Atcold/altair-tn9k/digital/README.md

# digital

Circuits for [Digital](https://github.com/hneemann/Digital), Helmut Neemann's logic simulator: the 74HC595 and 74HC165 built from flip-flops and gates, each with its test cases embedded.

## Building the chips

1. Build each chip as its own circuit, `s2p-74HC595.dig` (serial to parallel) and `p2s-74HC165.dig` (parallel to serial), with In/Out components labelled exactly as in the test vectors:
   - 595: `SER SRCLK RCLK ~SRCLR ~OE` → `QA … QH QH'`
   - 165: `SH/~LD CLK CLK_INH SER A … H` → `QH ~QH`

   `~` marks an active-low pin, which Digital draws with a bar over the name.
2. Flip-flops: Digital's D flip-flop, with asynchronous inputs enabled for the 595's shift register and all 165 stages. Its `Set` and `Clr` are active high, so invert them with the component's inverted-input option to match the drawings in `diagrams/`.
3. Tri-state outputs of the 595: the Driver component, or its inverted-select variant driven by `~OE` directly.
4. Add a Test component to each circuit, paste in the matching block of test vectors, and run the tests.
5. Once both pass, give each circuit the DIL shape in its settings and use it as a chip in a third circuit: chain two of each and drive LEDs and DIP switches, as on the breadboard.

## Test vectors

```sh
./test_vectors.py   # writes 74hc595-74hc165-tests.txt and s2p-74HC595-animation.hex
```

They come from a behavioural model of each chip in `test_vectors.py`, not from the datasheets directly, so if a test fails, check the vector as well as the circuit.

## Animation

`s2p-74HC595-animation.dig` replays the 595 test: a 5-bit counter steps a ROM through one test row per tick, and a splitter fans each word out to the inputs. Bits 0 to 4 of each word, matching the splitter outputs top to bottom:

| bit | 0 | 1 | 2 | 3 | 4 |
|---|---|---|---|---|---|
| input | ~OE | RCLK | SER | ~SRCLR | SRCLK |

Addresses past the last row hold the idle word `8` (only ~SRCLR high). The ROM keeps its own copy of the data, so after changing the vectors rerun `./test_vectors.py` and reload the ROM from the `.hex`.
