Atcold/altair-tn9k/docs/165-by-hand.tex

% One 74HC165 driven by hand: eight switches loaded at once, clocked out one by one onto a single LED.
% Build with ./build.sh (figures, then latexmk; settings in .latexmkrc).

\documentclass[11pt,a4paper]{article}

\usepackage{fontspec}
\usepackage[margin=2.5cm]{geometry}
\usepackage{graphicx}
\usepackage{float}
\usepackage{enumitem}
\usepackage{chapter}
\usepackage[colorlinks=true,linkcolor=blue!50!black,urlcolor=blue!50!black]{hyperref}

\setlength{\parindent}{0pt}
\setlength{\parskip}{0.6em}

\title{One \name{74HC165} by hand}
\author{}
\date{}

\begin{document}
\maketitle

\section*{Parts}

\section*{Power}

\section*{Wiring}

\section*{Procedure}

\section*{Done when}

\revisiontable

\end{document}
