Atcold/altair-tn9k/docs/index.tex

% The list of write-ups, one entry per stage; each links to its chapter's PDF beside it in build/.
% Build with ./build.sh (settings in .latexmkrc), which also writes index.md from this file.

\documentclass[11pt,a4paper]{article}

\usepackage{fontspec}
\usepackage[margin=2.5cm]{geometry}
\usepackage{enumitem}
\usepackage{chapter}
\usepackage[colorlinks=true,linkcolor=blue!50!black,urlcolor=blue!50!black,filecolor=blue!50!black]{hyperref}

\setlist[description]{style=nextline, leftmargin=1.5em}  % here, not on the list: pandoc skips lists with options
\setlength{\parindent}{0pt}
\setlength{\parskip}{0.6em}

\title{Altair 8800 replica on a Tang Nano 9K\\[0.3em]\large Write-ups}
\author{}
\date{}

\begin{document}
\maketitle

One chapter per stage of the build: what to wire, why, and how to tell it works.

\section*{Stages}

\begin{description}
  \item[\href{running-leds.pdf}{Stage 0a: running LEDs, with Gowin EDA and the open-source flow}]
    The old LED project rebuilt in Gowin EDA, step by step; then the same two files through the open-source flow, from a \name{Makefile}.
  \item[\href{hello-analyser.pdf}{Stage 0b: hello world on the logic analyser}]
    A Verilog UART sends ‘Hello world’, read back by the logic analyser’s decoder and by a serial terminal.
  \item[\href{595-by-hand.pdf}{Stage 0c: one \name{74HC595} by hand}]
    Three buttons stand in for the FPGA: shift a byte in bit by bit, then latch it onto eight LEDs.
  \item[\href{595-by-fpga.pdf}{Stage 1a: a walking bit on the \name{74HC595}}]
    The FPGA takes the buttons’ place: one lit LED walks forward a bit at a time, then backward a byte at a time.
\end{description}

\section*{The board}

\begin{description}
  \item[\href{the-board.pdf}{What is on the board}]
    The board’s parts and the documents that describe them, the \name{BL702} microcontroller behind the USB-C port, and how a USB keyboard could reach the FPGA.
  \item[\href{factory.pdf}{The factory program}]
    What the board runs out of the box, why it can’t be copied, and the design that puts it back after a \texttt{make flash}.
\end{description}

\section*{Schematics}

\begin{itemize}
  \item \href{74hc595-74hc165-internals.pdf}{The \name{74HC595} and \name{74HC165} at flip-flop level}
  \item \href{altair-first-byte-schematic.pdf}{First byte: one byte in, one byte out}
  \item \href{altair-panel-sr-schematic.pdf}{Panel}
\end{itemize}

The parts list is \name{docs/parts.md} in the repo.

\revisiontable

\end{document}
