Atcold/altair-tn9k/docs/index.md

# Altair 8800 replica on a Tang Nano 9K: Write-ups

One chapter per stage of the build: what to wire, why, and how to tell it works.

## Stages

[Stage 0a: running LEDs, with Gowin EDA and the open-source flow](build/running-leds.pdf)  
The old LED project rebuilt in Gowin EDA, step by step; then the same two files through the open-source flow, from a Makefile.

[Stage 0b: hello world on the logic analyser](build/hello-analyser.pdf)  
A Verilog UART sends ‘Hello world’, read back by the logic analyser’s decoder and by a serial terminal.

[Stage 0c: one 74HC595 by hand](build/595-by-hand.pdf)  
Three buttons stand in for the FPGA: shift a byte in bit by bit, then latch it onto eight LEDs.

[Stage 1a: a walking bit on the 74HC595](build/595-by-fpga.pdf)  
The FPGA takes the buttons’ place: one lit LED walks forward a bit at a time, then backward a byte at a time.

## The board

[What is on the board](build/the-board.pdf)  
The board’s parts and the documents that describe them, the BL702 microcontroller behind the USB-C port, and how a USB keyboard could reach the FPGA.

[The factory program](build/factory.pdf)  
What the board runs out of the box, why it can’t be copied, and the design that puts it back after a `make flash`.

## Schematics

- [The 74HC595 and 74HC165 at flip-flop level](build/74hc595-74hc165-internals.pdf)

- [First byte: one byte in, one byte out](build/altair-first-byte-schematic.pdf)

- [Panel](build/altair-panel-sr-schematic.pdf)

The parts list is docs/parts.md in the repo.

*Generated from index.tex by build.sh, which also builds the PDFs into build/. Edit index.tex, not this file.*
