Atcold/altair-tn9k/kicad/74HC595-manual-test/74HC595-manual-test.kicad_sch

## KiCad design kicad/74HC595-manual-test/74HC595-manual-test.kicad_sch (2026-10-24)

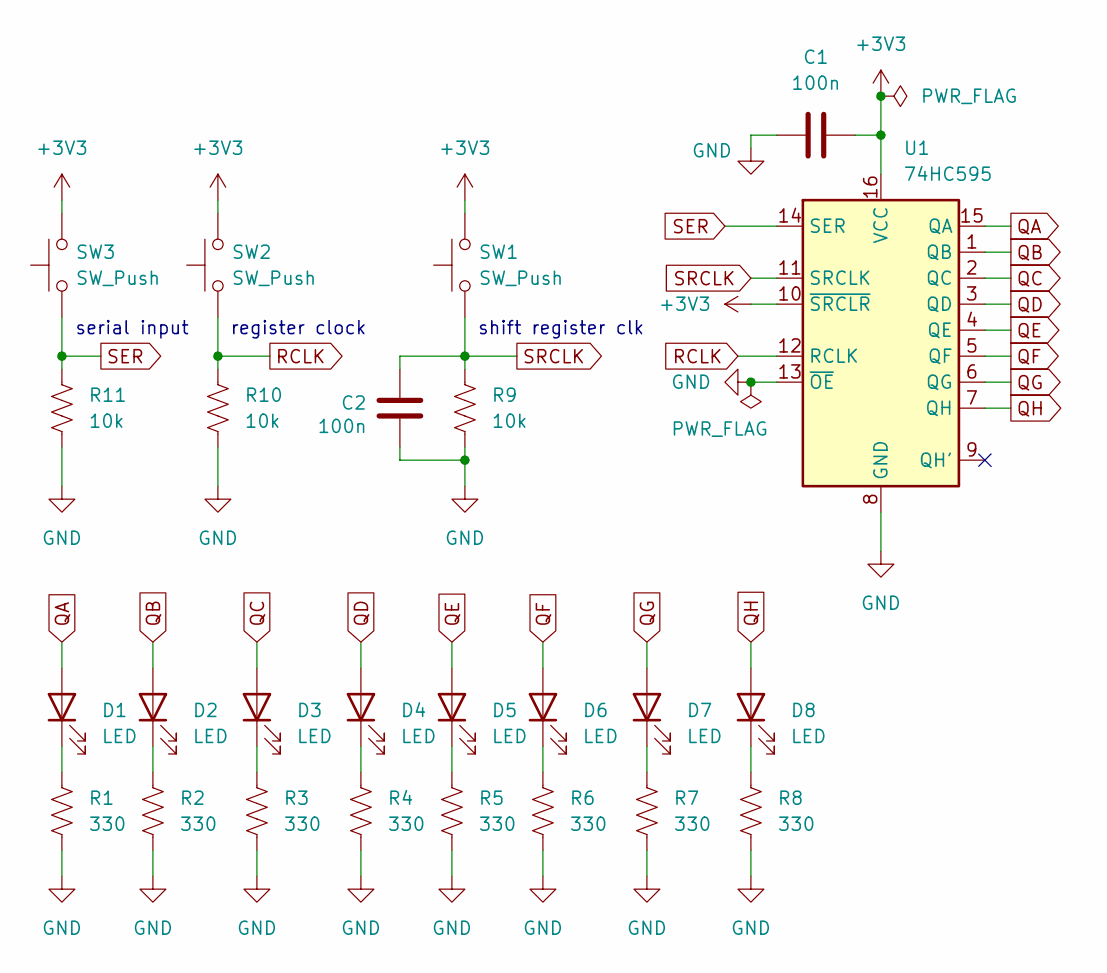
[picture p1: schematic 74HC595-manual-test.kicad_sch]

Parts:
C1, C2: 100n
D1, D2, D3, D4, D5, D6, D7, D8: LED
R1, R2, R3, R4, R5, R6, R7, R8: 330
R9, R10, R11: 10k
SW1, SW2, SW3: SW_Push
U1: 74HC595

Connections:
+3V3: C1.2, SW1.2, SW2.2, SW3.2, U1.10 (~SRCLR), U1.16 (VCC)
GND: C1.1, C2.2, R1.2, R2.2, R3.2, R4.2, R5.2, R6.2, R7.2, R8.2, R9.2, R10.2, R11.2, U1.8 (GND), U1.13 (~OE)
unnamed: D1.1 (K), R1.1
unnamed: D2.1 (K), R2.1
unnamed: D3.1 (K), R3.1
unnamed: D4.1 (K), R4.1
unnamed: D5.1 (K), R5.1
unnamed: D6.1 (K), R6.1
unnamed: D7.1 (K), R7.1
unnamed: D8.1 (K), R8.1
QA: D1.2 (A), U1.15 (QA)
QB: D2.2 (A), U1.1 (QB)
QC: D3.2 (A), U1.2 (QC)
QD: D4.2 (A), U1.3 (QD)
QE: D5.2 (A), U1.4 (QE)
QF: D6.2 (A), U1.5 (QF)
QG: D7.2 (A), U1.6 (QG)
QH: D8.2 (A), U1.7 (QH)
RCLK: R10.1, SW2.1, U1.12 (RCLK)
SER: R11.1, SW3.1, U1.14 (SER)
SRCLK: C2.1, R9.1, SW1.1, U1.11 (SRCLK)

Notes on the sheet:
shift register clk
serial input
register clock
