Atcold/altair-tn9k/diagrams/chips.py

"""74HC595 and 74HC165 drawn at flip-flop level, plus their function tables and pinouts.

Each sheet_* function returns one A3 figure; SHEETS lists them in PDF order.
"""
import schemdraw
import schemdraw.elements as elm
import schemdraw.logic as logic

from schematic import FS, T, page, canvas, finish, notes, table, tag, tunnel, ff, OV, net_colour

N = 3            # sheets in this set
TK = (0.36, 1.2, 1.1)   # tag sizing for these larger drawings: width per character, end padding, height
TKO = (0.36, 2.0, 1.1)  # output tags: extra room around the text
TK5 = (0.27, 1.0, 0.85) # the 74HC165 sheet is drawn larger, so its tags need less


def bus(d, y, xa, xb, text, k=None, kind="pin"):
    d.add(elm.Line().at((xa, y)).to((xb, y)).color(net_colour(text)))
    d.add(elm.Line().at((xa, y)).left(0.01)); tag(d, text, "left", k or TK, kind)


def clock_drops(d, flops, y):
    """Clock bus taps: from each flip-flop's clock input down to the bus at height y."""
    for c, f in enumerate(flops):
        cx = f.C.x - 0.5
        d.add(elm.Line().at(f.C).to((cx, f.C.y)).color(T.CLOCK))
        d.add(elm.Line().at((cx, f.C.y)).to((cx, y)).color(T.CLOCK))
        if c < len(flops) - 1:
            d.add(elm.Dot().at((cx, y)).color(T.CLOCK))


# ================================================================ 74HC595
def sheet_595():
    fig, fr = page(1, N, "74HC595 at flip-flop level: 8-bit shift register + 8-bit storage register + tri-state outputs",
                   "74HC595 internals")
    ax = canvas(fig, [0.03, 0.27, 0.94, 0.65])
    d = schemdraw.Drawing(canvas=ax, show=False)
    PITCH, SOFF, SY, ROW = 12.0, 6.2, -7.2, 22.0
    names = "ABCDEFGH"
    outs = ["QA (15)", "QB (1)", "QC (2)", "QD (3)", "QE (4)", "QF (5)", "QG (6)", "QH (7)"]
    DT, CT = T.DATA, T.CONTROL
    for r in range(2):
        Y = -r * ROW
        sh, st, tris = [], [], []
        for c in range(4):
            i = 4 * r + c
            x = c * PITCH
            sh.append(d.add(ff([(OV("CLR"), "CLR")], w=3.0, h=3.6, label=f"shift {names[i]}").at((x, Y))))
            st.append(d.add(ff(w=3.0, h=3.6, label=f"store {names[i]}").at((x + SOFF, Y + SY))))
        x0 = sh[0].D.x - 2.2
        d.add(elm.Line().at(sh[0].D).left(2.2).color(DT))
        if r == 0:
            tag(d, "SER  (14)", "left", TK)
        else:
            tunnel(d, "shift D→E", "left")
        for c in range(4):
            i = 4 * r + c
            q = sh[c].Q
            tapx = q.x + 0.6
            if c < 3:
                d.add(elm.Line().at(q).to(sh[c + 1].D).color(DT))
            else:
                d.add(elm.Line().at(q).right(2.5).color(DT))
                if i == 7:
                    tag(d, "QH'  (9)", "right", TK)
                else:
                    tunnel(d, "shift D→E", "right")
            d.add(elm.Dot().at((tapx, q.y)).color(DT))
            d.add(elm.Line().at((tapx, q.y)).to((tapx, st[c].D.y)).color(DT))
            d.add(elm.Line().at((tapx, st[c].D.y)).to(st[c].D).color(DT))
        yclr = sh[0].CLR.y + 0.9
        bus(d, yclr, x0, sh[3].CLR.x, OV("SRCLR") + "  (10)")
        for c, s_ in enumerate(sh):
            d.add(elm.Line().at(s_.CLR).to((s_.CLR.x, yclr)).color(CT))
            if c < 3:
                d.add(elm.Dot().at((s_.CLR.x, yclr)).color(CT))
        ysck = sh[0].C.y - 2.6  # low enough to clear the "shift A" names under the boxes
        bus(d, ysck, x0, sh[3].C.x - 0.5, "SRCLK  (11)")
        yrck = st[0].C.y - 2.6
        bus(d, yrck, x0, st[3].C.x - 0.5, "RCLK  (12)")
        clock_drops(d, sh, ysck)
        clock_drops(d, st, yrck)
        ytri = yrck - 1.4  # output buffers sit below the RCLK bus, drawn left to right
        for c, t in enumerate(st):
            i = 4 * r + c
            xb = t.Q.x + 0.8
            d.add(elm.Line().at(t.Q).to((xb, t.Q.y)).color(DT))
            d.add(elm.Line().at((xb, t.Q.y)).to((xb, ytri)).color(DT))
            # non-inverting tri-state buffer (schemdraw's default is an inverter); flip: enable underneath
            tb = d.add(logic.Tristate(outputnot=False).right().flip().at((xb, ytri)).length(2.4))
            tris.append(tb)
            d.add(elm.Line().at(tb.end).right(0.3).color(DT))
            tag(d, outs[i], "right", TKO)
        yoe = ytri - 1.6  # OE bus below the buffers
        for c, tb in enumerate(tris):
            d.add(elm.Line().at(tb.c).to((tb.c.x, yoe)).color(CT))
            if c < 3:
                d.add(elm.Dot().at((tb.c.x, yoe)).color(CT))
        if r == 0:
            d.add(elm.Line().at((x0 + 4.2, yoe)).to((tris[3].c.x, yoe)).color(CT))
            d.add(logic.Not().right().at((x0 + 0.6, yoe)).length(3.6).color(CT))
            d.add(elm.Line().at((x0 + 0.6, yoe)).left(0.01)); tag(d, OV("OE") + "  (13)", "left", TK)
            d.add(elm.Label().at((x0 + 5.2, yoe + 0.6)).label("OE (internal)", fontsize=FS - 1))
        else:
            bus(d, yoe, x0, tris[3].c.x, "OE (internal)", kind="tunnel")
    finish(d, ax, pad=0.5)

    notes(fr, 0.03, 0.245, [
        "Shift register: on each rising edge of SRCLK, SER enters stage A and every stage passes its bit to the next (A→B→…→H).",
        "Stage H also drives QH' (pin 9), the serial output used to chain the next 595. QH' is never tri-stated.",
        "Storage register: on each rising edge of RCLK, all eight shift-register bits are copied at once into the storage flip-flops,",
        "which is why the LEDs never show bits sliding past: outputs only change on RCLK.",
        f"{OV('SRCLR')} low clears the shift register only (asynchronously). The storage register keeps its value until the next RCLK.",
        f"{OV('OE')} high puts QA–QH in high impedance. On the panel it is tied to GND, so outputs are always driven.",
        "Drawn in two rows for legibility. Pointed boxes are pins; a filled triangle is a tunnel, the same wire as the one with its name.",
        "All flip-flops are rising-edge D-types (the wedge marks the clock input).",
    ], title="How it works", size=10)
    return fig


# ================================================================ 74HC165
def sheet_165():
    fig, fr = page(2, N, "74HC165 at flip-flop level: 8-bit shift register with asynchronous parallel load",
                   "74HC165 internals")
    ax = canvas(fig, [0.03, 0.27, 0.94, 0.65])
    d = schemdraw.Drawing(canvas=ax, show=False)
    PITCH, ROW = 9.5, 15.8
    names = "ABCDEFGH"
    pins_in = ["A (11)", "B (12)", "C (13)", "D (14)", "E (3)", "F (4)", "G (5)", "H (6)"]
    DT, CT = T.DATA, T.CONTROL
    for r in range(2):
        Y = -r * ROW
        fs_ = []
        for c in range(4):
            i = 4 * r + c
            fs_.append(d.add(ff([(OV("PRE"), "PRE"), (OV("CLR"), "CLR")], w=5.0, h=3.6, label=f"stage {names[i]}",
                                qn=(i == 7)).at((c * PITCH, Y))))  # only stage H's Q-bar is used: pin 7
        x0 = fs_[0].D.x - 2.2
        d.add(elm.Line().at(fs_[0].D).left(2.2).color(DT))
        if r == 0:
            tag(d, "SER  (10)", "left", TK5)
        else:
            tunnel(d, "stage D→E", "left")
        for c in range(3):
            d.add(elm.Line().at(fs_[c].Q).to(fs_[c + 1].D).color(DT))
        if r == 0:
            d.add(elm.Line().at(fs_[3].Q).right(1.8).color(DT)); tunnel(d, "stage D→E", "right")
        else:
            d.add(elm.Line().at(fs_[3].Q).right(1.8).color(DT)); tag(d, "QH  (9)", "right", TK5)
            d.add(elm.Line().at(fs_[3].QN).right(1.8).color(DT)); tag(d, OV("QH") + "  (7)", "right", TK5)

        gl = 1.85
        yload = fs_[0].PRE.y + 0.5 + gl + 1.4
        for c, f in enumerate(fs_):
            i = 4 * r + c
            pre, clr = f.PRE, f.CLR
            # input 1 of each NAND is SH/LD, active low (bubble)
            n1 = d.add(logic.Nand(inputnots=[1]).down().anchor("out").at((pre.x, pre.y + 0.5)))
            d.add(elm.Line().at(n1.out).to(pre).color(CT))
            n2 = d.add(logic.Nand(inputnots=[1]).down().anchor("out").at((clr.x, clr.y + 0.5)))
            d.add(elm.Line().at(n2.out).to(clr).color(CT))
            ydot = pre.y + 0.25
            xm = (pre.x + clr.x) / 2
            ytop = n2.in2.y + 0.5
            d.add(elm.Dot().at((pre.x, ydot)).color(CT))
            d.add(elm.Line().at((pre.x, ydot)).to((xm, ydot)).color(CT))
            d.add(elm.Line().at((xm, ydot)).to((xm, ytop)).color(CT))
            d.add(elm.Line().at((xm, ytop)).to((n2.in2.x, ytop)).color(CT))
            d.add(elm.Line().at((n2.in2.x, ytop)).to(n2.in2).color(CT))
            for g in (n1, n2):
                d.add(elm.Line().at(g.in1).to((g.in1.x, yload)).color(CT))
                if not (c == 3 and g is n2):
                    d.add(elm.Dot().at((g.in1.x, yload)).color(CT))
            # parallel input: up from the left NAND, then left into an input tag
            top = (n1.in2.x, yload + 1.5)
            d.add(elm.Line().at(n1.in2).to(top).color(DT))
            d.add(elm.Line().at(top).left(0.8).color(DT))
            tag(d, pins_in[i], "left", TK5)
        bus(d, yload, x0, fs_[3].CLR.x + 0.25, "SH/" + OV("LD") + "  (1)", TK5)

        yck = fs_[0].C.y - 2.6  # low enough to clear the "stage A" names under the boxes
        clock_drops(d, fs_, yck)
        if r == 0:
            # OR gate far enough left that the CLK (internal) name fits before the first branch
            K = T.CLOCK
            org = d.add(logic.Or().right().anchor("out").at((x0 - 1.4, yck)))
            d.add(elm.Line().at(org.out).to((fs_[3].C.x - 0.5, yck)).color(K))
            d.add(elm.Label().at((x0 - 0.5, yck + 0.45)).label("CLK (internal)", fontsize=FS - 1))
            d.add(elm.Line().at(org.in1).left(0.6).color(K)); d.add(elm.Line().up(0.6).color(K))
            d.add(elm.Line().left(0.4).color(K))
            tag(d, "CLK  (2)", "left", TK5)
            d.add(elm.Line().at(org.in2).left(0.6).color(K)); d.add(elm.Line().down(0.6).color(K))
            d.add(elm.Line().left(0.4).color(K))
            tag(d, "CLK INH  (15)", "left", TK5)
        else:
            bus(d, yck, x0, fs_[3].C.x - 0.5, "CLK (internal)", TK5, kind="tunnel")
    finish(d, ax, pad=0.5)

    notes(fr, 0.03, 0.245, [
        f"Parallel load: SH/{OV('LD')} goes to every stage. While it is low, the two NANDs (bubble = active-low input) turn the input bit into an asynchronous preset or clear:",
        f"input 1  →  left NAND outputs 0  →  {OV('PRE')} active  →  Q = 1;   input 0  →  right NAND outputs 0  →  {OV('CLR')} active  →  Q = 0.",
        "The load is asynchronous and continuous: while SH/LD is low, Q follows the inputs and the clock is ignored.",
        "Shift: with SH/LD high both NANDs output 1 (inactive). Each rising edge of the internal clock moves SER into A and A…G into B…H.",
        "QH is stage H, so right after a load it already shows input H: the first bit is readable before any clock pulse.",
        "Internal clock = CLK OR CLK INH, so either input held high blocks the other. Change CLK INH only while CLK is high, or its edge acts as a clock.",
        "Drawn in two rows for legibility. Pointed boxes are pins; a filled triangle is a tunnel, the same wire as the one with its name.",
        "All flip-flops are rising-edge D-types (the wedge marks the clock input).",
    ], title="How it works", size=10)
    return fig


# ================================================================ tables
def sheet_tables():
    fig, fr = page(3, N, "Function tables and pinouts", "Function tables, pinouts")
    table(fig, [0.03, 0.62, 0.45, 0.28], "74HC595 function table  (↑ = rising edge)",
          ["SER", "SRCLK", OV("SRCLR"), "RCLK", OV("OE"), "Effect"],
          [["X", "X", "X", "X", "H", "QA–QH high impedance (QH' unaffected)"],
           ["X", "X", "L", "X", "X", "Shift register cleared"],
           ["L", "↑", "H", "X", "X", "Shift; stage A = 0"],
           ["H", "↑", "H", "X", "X", "Shift; stage A = 1"],
           ["X", "X", "X", "↑", "X", "Shift register copied to storage"],
           ["X", "X", "X", "X", "L", "Storage driven onto QA–QH"]],
          [0.07, 0.10, 0.10, 0.09, 0.08, 0.56])
    table(fig, [0.52, 0.62, 0.45, 0.28], "74HC165 function table",
          ["SH/" + OV("LD"), "CLK", "CLK INH", "Effect"],
          [["L", "X", "X", "Parallel load: A–H copied to stages (async)"],
           ["H", "L", "L", "Hold"],
           ["H", "↑", "L", "Shift; SER → A, …, G → H"],
           ["H", "X", "H", "Hold (clock inhibited)"],
           ["H", "L", "↑", "Shift (the two clock inputs are interchangeable)"],
           ["H", "H", "X", "Hold"]],
          [0.11, 0.09, 0.12, 0.68])

    table(fig, [0.03, 0.33, 0.45, 0.24], "DIP-16 pinouts (top view, pin 1 top left)",
          ["Pin", "74HC595", "Pin", "74HC595", "Pin", "74HC165", "Pin", "74HC165"],
          [["1", "QB", "16", "VCC", "1", "SH/" + OV("LD"), "16", "VCC"],
           ["2", "QC", "15", "QA", "2", "CLK", "15", "CLK INH"],
           ["3", "QD", "14", "SER", "3", "E", "14", "D"],
           ["4", "QE", "13", OV("OE"), "4", "F", "13", "C"],
           ["5", "QF", "12", "RCLK", "5", "G", "12", "B"],
           ["6", "QG", "11", "SRCLK", "6", "H", "11", "A"],
           ["7", "QH", "10", OV("SRCLR"), "7", OV("QH"), "10", "SER"],
           ["8", "GND", "9", "QH'", "8", "GND", "9", "QH"]],
          [0.08, 0.17, 0.08, 0.17, 0.08, 0.17, 0.08, 0.17], fs=8.5)

    notes(fr, 0.03, 0.28, [
        "Pin names with a bar are active low.",
        "Sources: TI SN74HC595 and SN74HC165 datasheets (logic diagrams and function tables).",
    ], size=9)
    return fig


SHEETS = [sheet_595, sheet_165, sheet_tables]
