Atcold/altair-tn9k/(commit log)

2026-10-06 Initial layout: two panel backends, KiCad, Digital, notebooks
2026-10-06 Add schematic notebook and Digital test vectors
    diagrams/: schemdraw drawings of the shift-register panel (five sheets)
    and of the 74HC595 and 74HC165 at flip-flop level (three sheets), shown
    one per cell in schematics.ipynb; build_pdfs.py writes them as PDFs to
    docs/, light by default or --dark.
    digital/: test-vector generator for the two chips and notes on building
    them in Digital.
    pyproject.toml and uv.lock define the Python environment.
    [build_pdfs.py, chips.py, panel_sr.py, schematic.py]
2026-10-06 Add SPI-expander panel sheets; tidy symbols on both backends
    panel_mcp.py draws the MCP23S17 backend in five sheets: block diagram,
    carrier and connector, output expander, input expander, and bit maps
    with the start-up register writes. The notebook shows them and
    build_pdfs.py writes them as a third PDF; the panel PDFs are now named
    by backend.
    On both backends: toggle glyphs under the input chips in the block
    diagrams, LED part references LED1..LED36 instead of D1..D36 (which
    clashed with the data lights D0..D7), accurate "alike" sheet titles,
    a node where the decoupling capacitor meets the supply, and X marks on
    unconnected pins.
2026-10-06 First-byte breadboard sheet, colour themes, reworked chip internals
    diagrams/first_byte.py: the first breadboard, one byte each way on both
    backends sharing one DIP switch, plus a sheet of FPGA pins, parts and
    test. The panel sets drop their breadboard-subset tables.
    Themes: light (colour, the PDF default), dark (notebook) and mono
    (black and white); build_pdfs.py takes --dark or --mono. Nets are
    coloured by kind: supply, ground, clocks, each backend's signals, the
    shared switch lines, chip-internal data and control, LEDs.
    Net tags are drawn as text boxes sized in points, so they are the same
    size on every sheet.
    Chip internals: clock wedges on the flip-flops, non-inverting output
    buffers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
    [build_pdfs.py, chips.py, first_byte.py, panel_mcp.py, panel_sr.py, schematic.py]
2026-10-07 Add 74HC595 shift stage in Digital; use ~ for active-low pins
2026-10-08 Complete 74HC595 in Digital: storage register, ~OE tri-state outputs, ~SRCLR, QH', test case
2026-10-23 Add KiCad schematic for 74HC595 manual test
2026-10-24 KiCad 74HC595 test: LED bank, debounce cap on SRCLK, power flags
2026-10-24 Write-ups in LaTeX: index, Stage 0c chapter, debounce figures
    docs/ holds the chapter sources and chapter.sty; build.sh draws the figures, exports the KiCad sheet, builds the PDFs into docs/build/ and writes index.md from index.tex. The debounce waveforms come from diagrams/debounce.ipynb, which writes docs/data/; like fig/ and build/, it stays out of git. Schematic PDFs now also go to docs/build/.
2026-10-25 Debounce notebook: τ, v_pulldown, count_rising_edges, spelled-out VIL/VIH
2026-10-25 Stage 0c: explain the bounce simulation, with code, theory and references
2026-10-26 Open flow: Makefile, led and factory designs
2026-10-26 Docs: running LEDs, hello analyser, walking bit, factory
2026-10-26 README: download the OSS CAD Suite
2026-11-01 Hello-world UART and walking-bit designs, with testbenches
2026-11-01 Docs: set the board's name in sans with \name, as chips are
2026-11-01 Roadmap: the walking bit is built and runs on the board
2026-11-01 Docs: new lesson on the board's parts and its BL702 USB bridge
2026-11-10 docs: ship alfdoc.sty; chapter.sty keeps only the board drawings
